Battosai42/CraftbotPlus_Upgrade/Slicer_Profiles/README.md

# Slicer Profiles

Currently there are slicer profiles for the following slicers:

- [X] [SuperSlicer](https://github.com/supermerill/SuperSlicer)

These slicer profiles work but are still under developement not opimised yet.
