Battosai42/CraftbotPlus_Upgrade/Images/mks_tft32_2.jpg

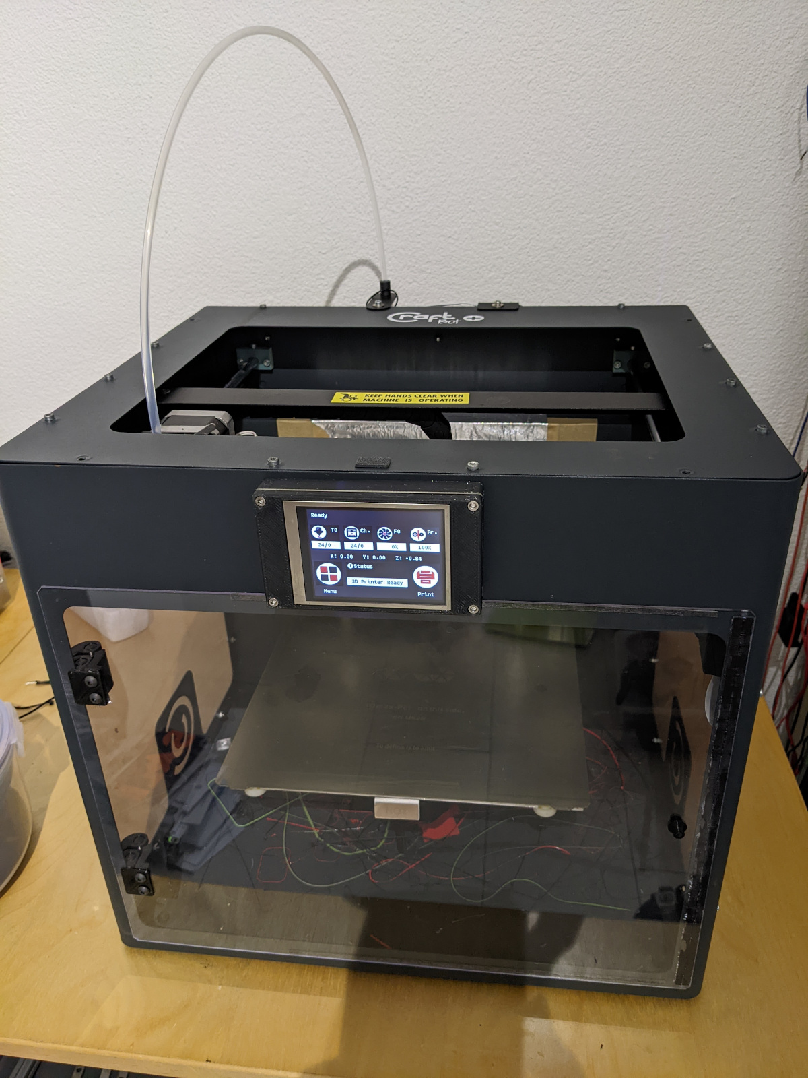
Images/mks_tft32_2.jpg
