Battosai42/CraftbotPlus_Upgrade/Upgrade_Parts/README.md

# CAD 
The following design tool are used used for all parts in this folder:

- All mechanical parts are designed in FreeCad v0.19
- All PCB's are designed in KiCad v6.0

## Printed Parts
PLA is prticularily unsuited for this application as it kreeps under stress and will become soft in the ambient temperature in the enclosure. I recommend printing the parts in ABS or another polymer with a high glass transition point as they will be operated at elevated temperatures of 50+ °C when the enclosure hood is used which makes the printer better suited to print more advanced filaments such as ABS or Nylon. 

Slicer Settings:
- 4 perimeters @0.4mm (1.6mm)
- 8 top/bottom layers @0.2mm (1.6mm)
- 40% infill

## External Mods
- [CraftBot Airflow Improvement Module (AIM)](https://www.thingiverse.com/thing:1100665)
- [Craftbot Hidden Hinge for a Front Door](https://www.thingiverse.com/thing:1472094)

## My older mods hosted on thingiverse
- [Craftbot Camera Mount](https://www.thingiverse.com/thing:2874058)
- [Craftbot Plus Belt Spacer](https://www.thingiverse.com/thing:2840977)
