Battosai42/CraftbotPlus_Upgrade/BOM.ods

BOM for Craftbot Plus Modifications
Items | Description | Link | Price
1 | Duet 3 Mini 5+ | https://e3d-online.com/products/duet-3-mini-5
1 | Duet PanelDue | https://e3d-online.com/products/duet-paneldue-display?_pos=1&_sid=3085afdef&_ss=r
 |  | Total Price | 0
