Battosai42/CraftbotPlus_Upgrade/Upgrade_Parts/Electronics/electronics_mounts.FCStd

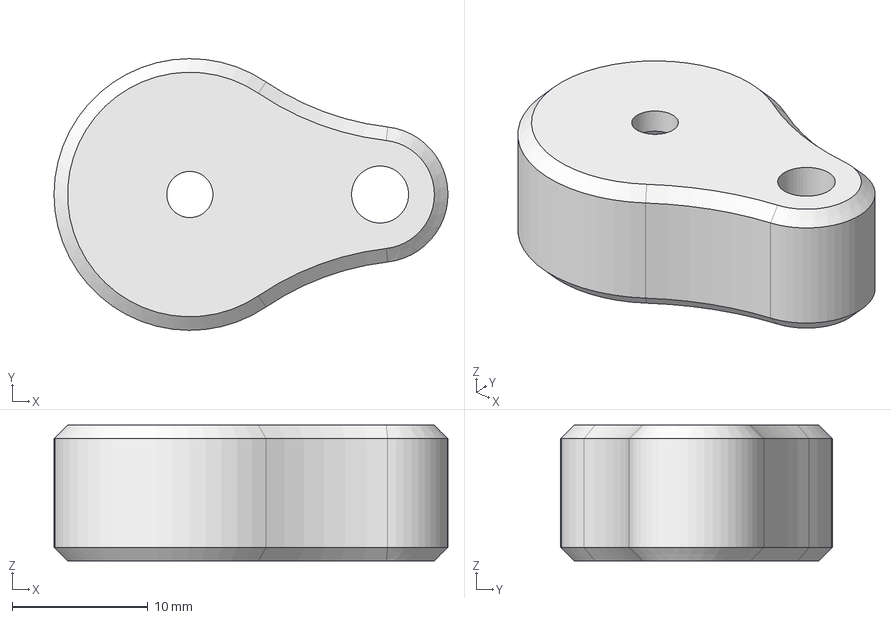
[picture p10: CAD file, 2022-03-01]
Upgrade_Parts/Electronics/electronics_mounts.FCStd
29.0 x 20.0 x 10.0 mm
