Battosai42/CraftbotPlus_Upgrade/Upgrade_Parts/Extruder/IR_probe_mount.FCStd

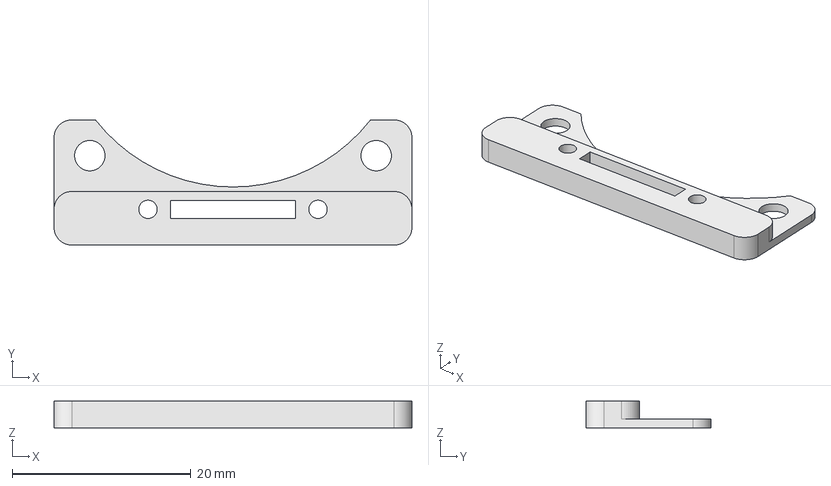
[picture p11: CAD file, 2022-03-01]
Upgrade_Parts/Extruder/IR_probe_mount.FCStd
40.0 x 14.0 x 3.00 mm
