Battosai42/CraftbotPlus_Upgrade/Upgrade_Parts/usb_lid.amf

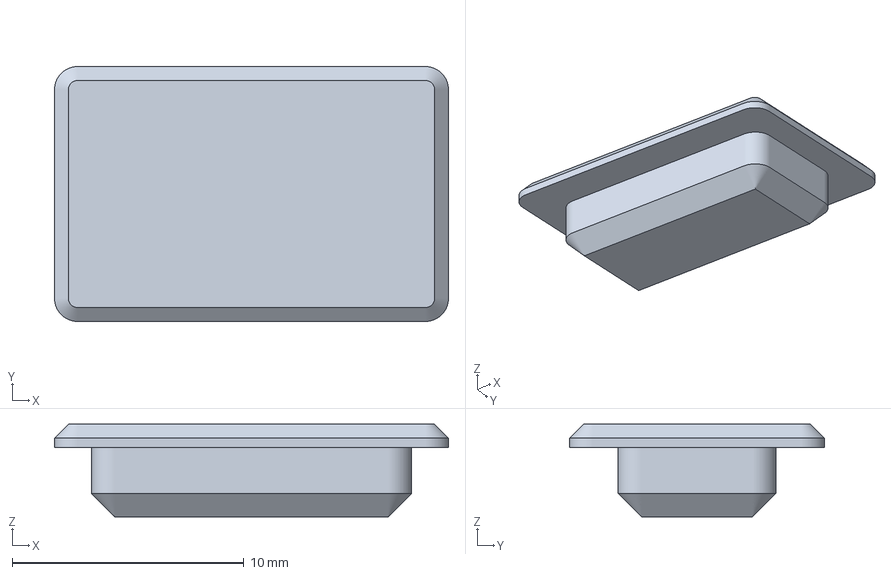
[picture p12: CAD file, 2022-04-02]
Upgrade_Parts/usb_lid.amf
17.0 x 11.0 x 4.00 mm
