Battosai42/CraftbotPlus_Upgrade/Upgrade_Parts/MKS_TFT32_mount.amf

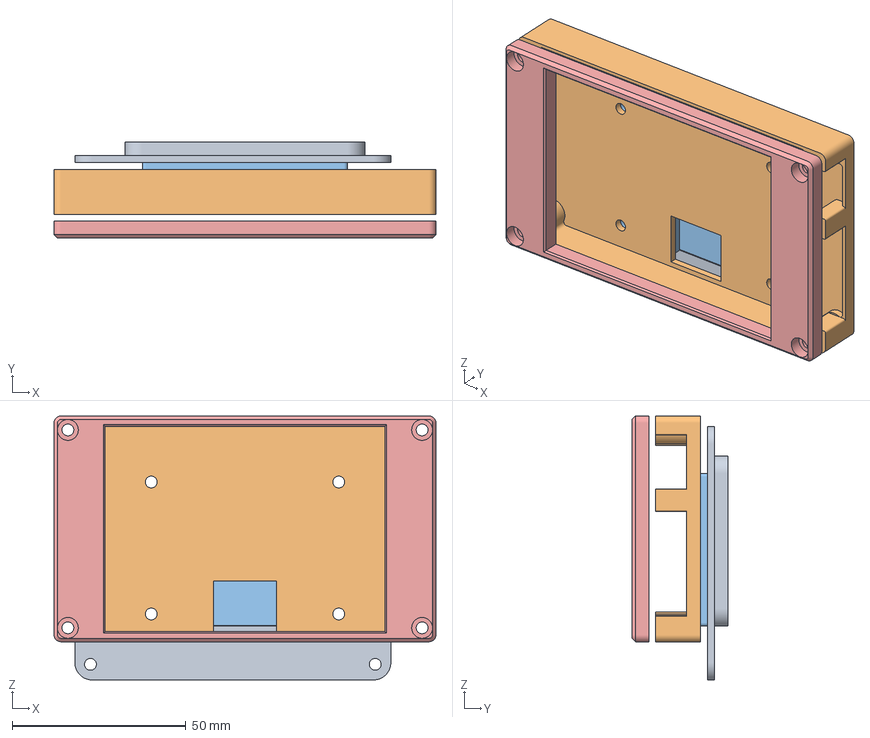
[picture p13: CAD file, 2022-04-02]
Upgrade_Parts/MKS_TFT32_mount.amf
110.0 x 27.8 x 76.0 mm
MKS_Mounting_Bracket
MKS_case_back
spacer
cable_lid
screen_bezel
