Battosai42/CraftbotPlus_Upgrade/Upgrade_Parts/BLV_Toolhead_Interface/BLV_Toolhead_Interface.pdf

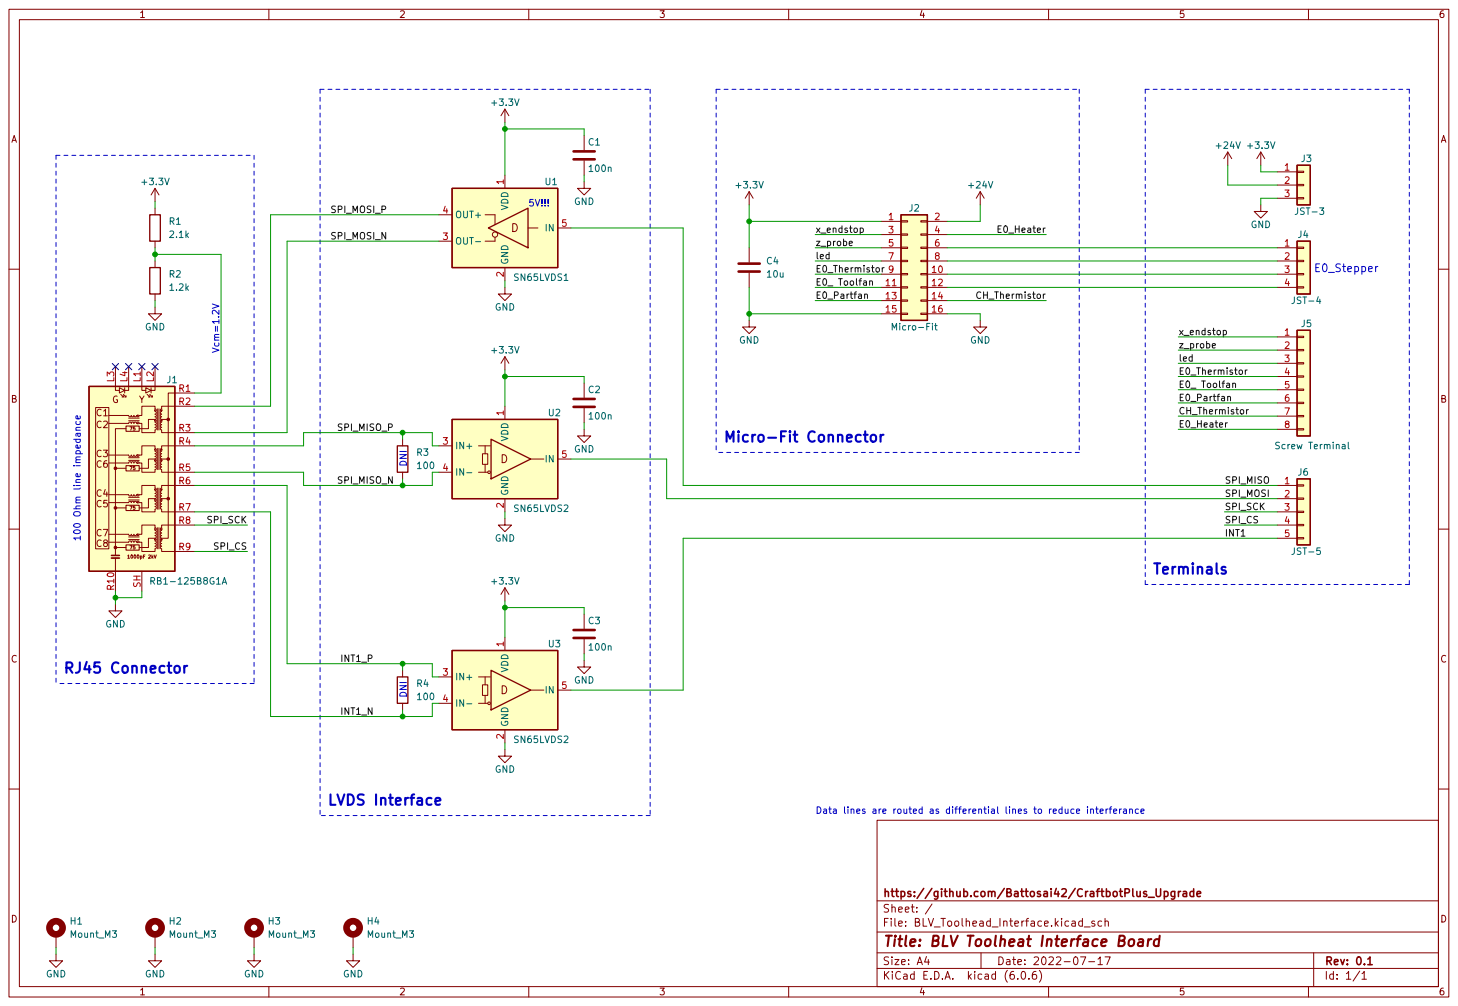
[picture p14: page 1]

SPI_MOSI_N

File: BLV_Toolhead_Interface.kicad_sch Sheet: / https://github.com/Battosai42/CraftbotPlus_Upgrade GND

Data lines are routed as differential lines to reduce interferance

Id: 1/1 Title: BLV Toolheat Interface Board
