Battosai42/CraftbotPlus_Upgrade/Upgrade_Parts/BLV_Toolhead_PCB/CB_Toolhead_PCB.pdf

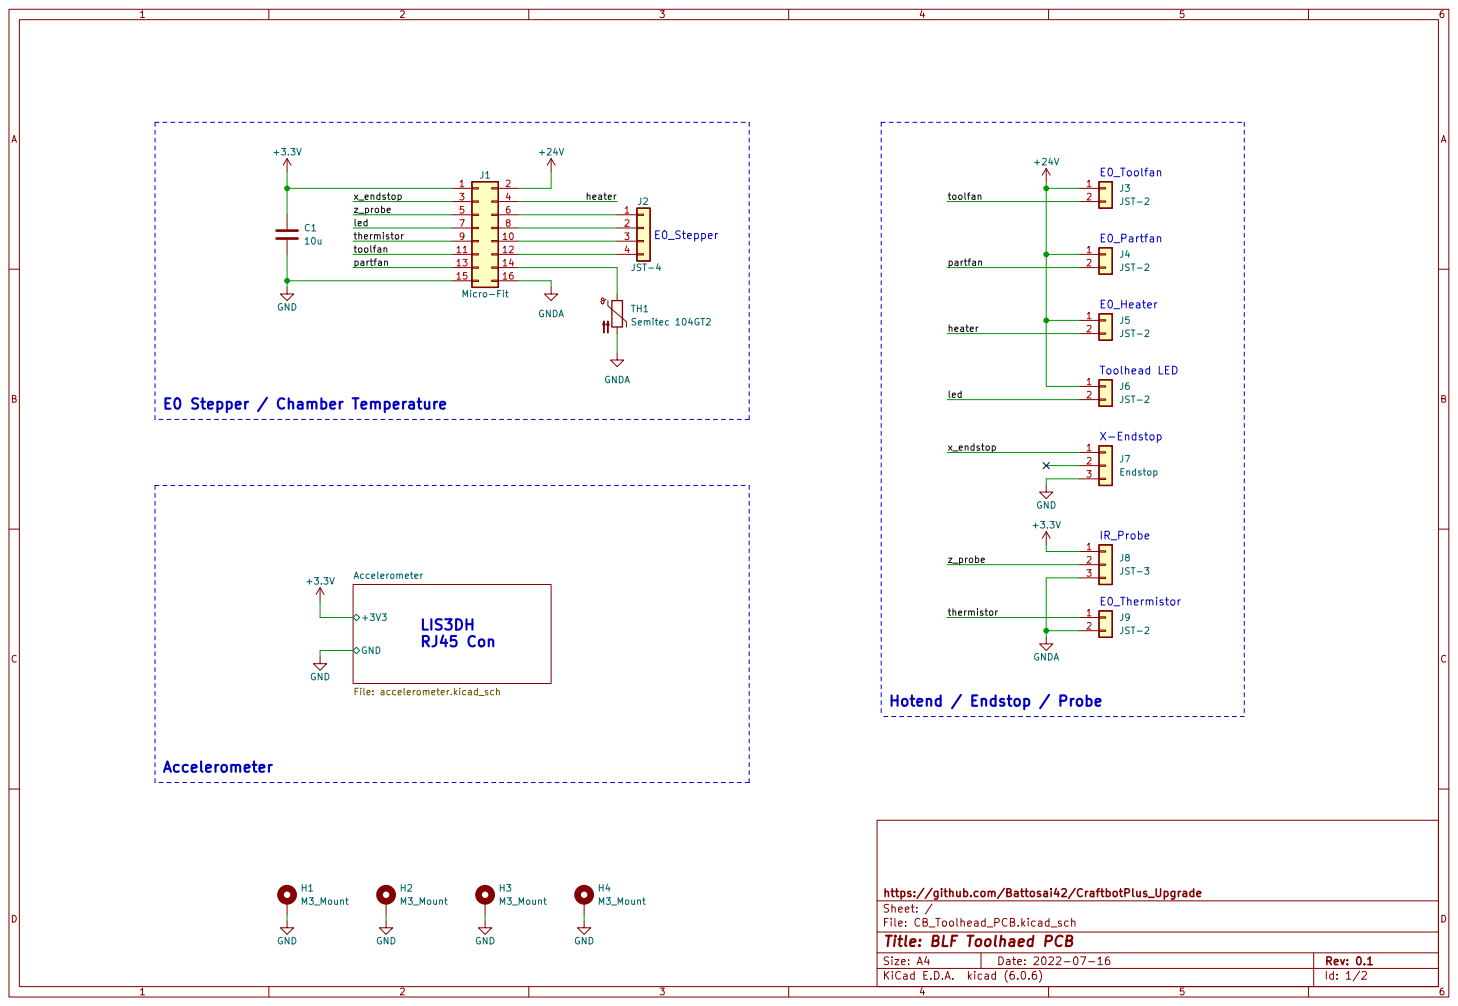
[picture p15: page 1]

File: CB_Toolhead_PCB.kicad_sch Sheet: / https://github.com/Battosai42/CraftbotPlus_Upgrade GND

Id: 1/2 Title: BLF Toolhaed PCB

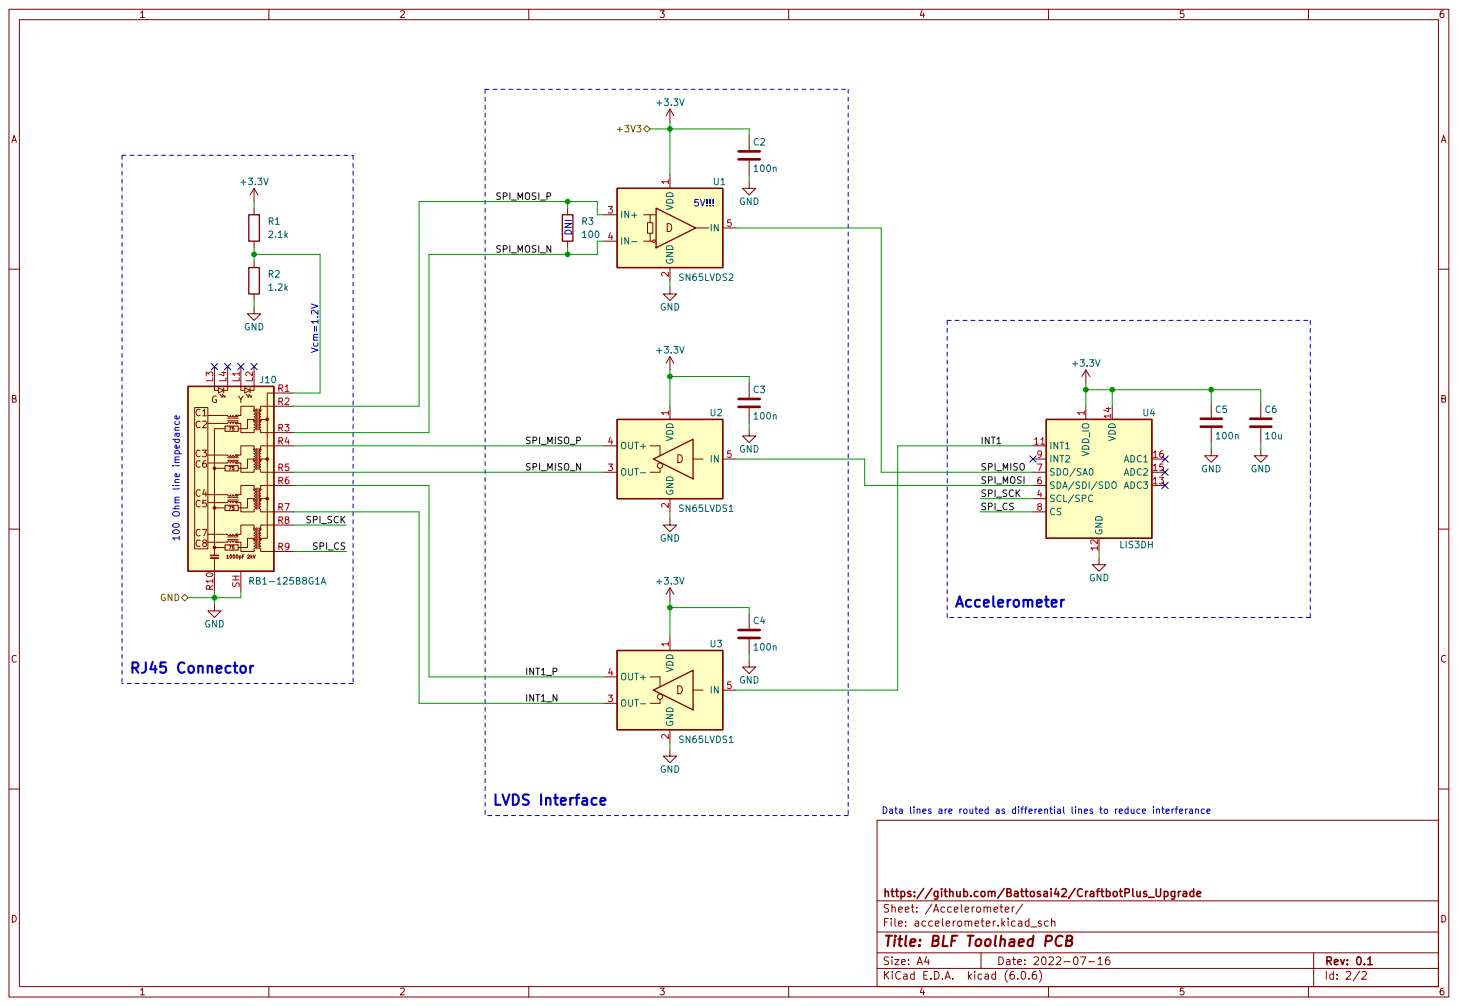
[picture p16: page 2]

LVDS Interface 100 Ohm line impedance

File: accelerometer.kicad_sch Sheet: /Accelerometer/ https://github.com/Battosai42/CraftbotPlus_Upgrade C4

Data lines are routed as differential lines to reduce interferance

Id: 2/2 Title: BLF Toolhaed PCB
