Battosai42/CraftbotPlus_Upgrade/Upgrade_Parts/BLV_Toolhead_PCB/CB_Toolhead_PCB.kicad_pcb

## KiCad design Upgrade_Parts/BLV_Toolhead_PCB/CB_Toolhead_PCB.kicad_pcb (2022-08-03)

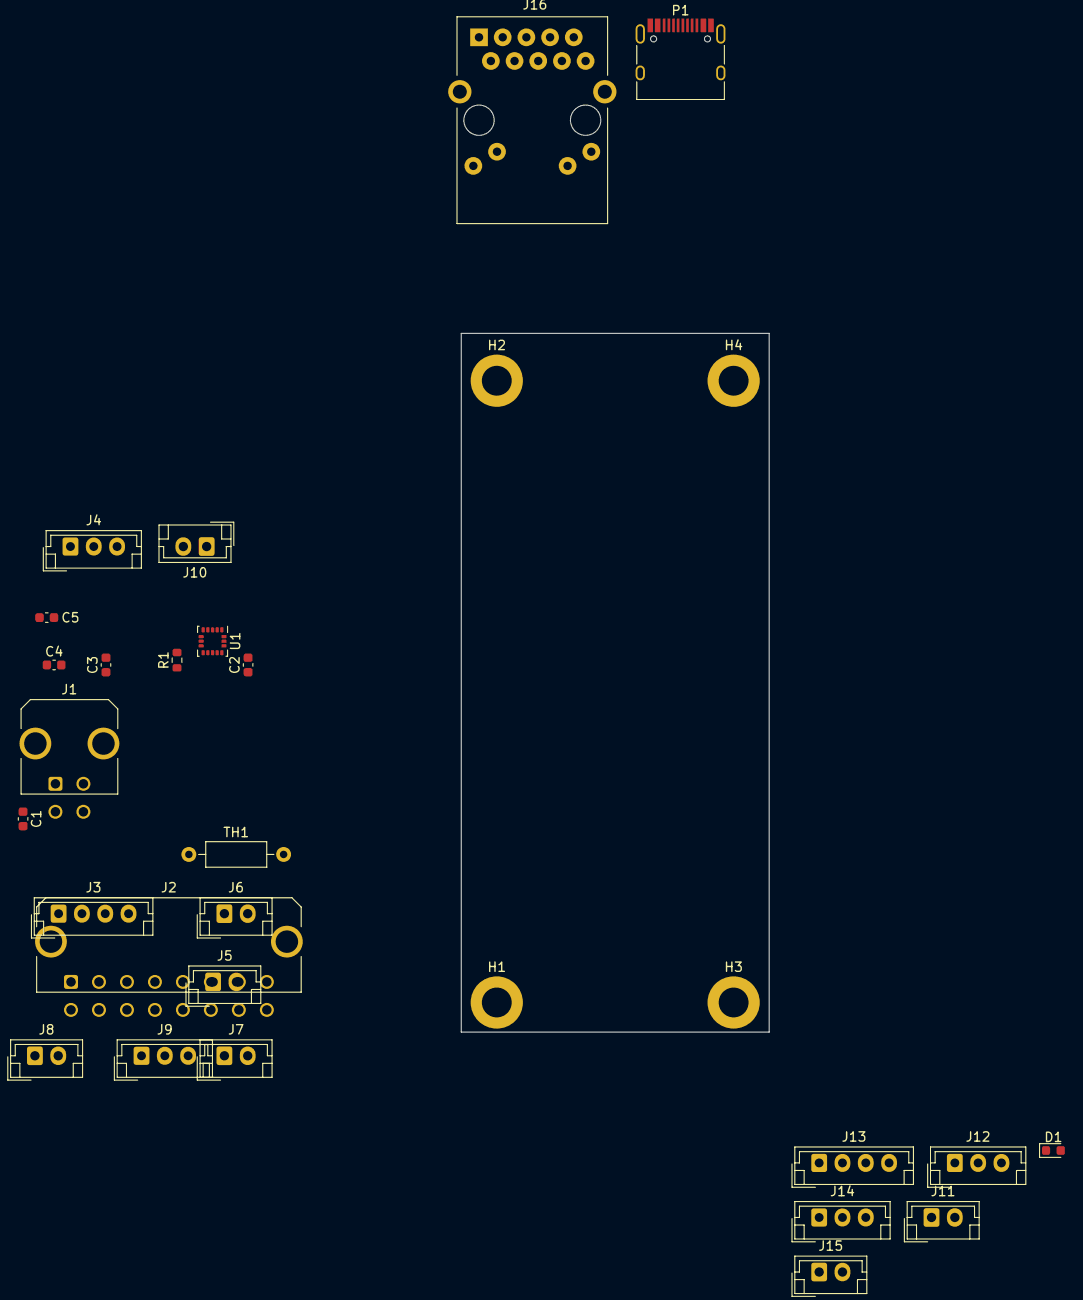
[picture p17: board CB_Toolhead_PCB.kicad_pcb from above]

Board: 2 copper layers, 33.0 x 74.9 mm, 30 parts (0 on the bottom side), 26 nets, no tracks yet.

Parts:
C1, C2, C3, C5: 10u; C_0603_1608Metric
C4: 100n; C_0603_1608Metric
D1: BAS; D_0603_1608Metric
H1, H2, H3, H4: M3_Mount; MountingHole_3.2mm_M3_DIN965_Pad
J1: Power; Molex_Micro-Fit_3.0_43045-0421_2x02-1MP_P3.00mm_Horizontal
J2: Micro-Fit; Molex_Micro-Fit_3.0_43045-1621_2x08-1MP_P3.00mm_Horizontal
J3, J13: JST-4; JST_EH_B4B-EH-A_1x04_P2.50mm_Vertical
J4, J12, J14: JST-3; JST_EH_B3B-EH-A_1x03_P2.50mm_Vertical
J5, J6, J7, J8, J10, J11, J15: JST-2; JST_EH_B2B-EH-A_1x02_P2.50mm_Vertical
J9: Endstop; JST_EH_B3B-EH-A_1x03_P2.50mm_Vertical
J16: RB1-125B8G1A; RJ45_UDE_RB1-125B8G1A
P1: USB_C_Plug_USB2.0; USB_C_Receptacle_HRO_TYPE-C-31-M-12
R1: 470R; R_0603_1608Metric
TH1: Semitec 104GT2; R_Axial_DIN0207_L6.3mm_D2.5mm_P10.16mm_Horizontal
U1: LIS3DH; LGA-16_3x3mm_P0.5mm_LayoutBorder3x5y

Connections:
+3V3: C2.1, C4.1, C5.1, J1.1, J12.1, U1.1 (VDD_IO), U1.14 (VDD)
+5V: C3.1, J1.3, J4.1, J13.1, J14.2
+24V: C1.1, J1.2, J5.1, J6.1, J7.1, J8.1, J10.1
/1A: J2.4, J3.1
/1B: J2.6, J3.2
/2A: J2.8, J3.3
/2B: J2.10, J3.4
/Accelerometer1/INT1: J16.R8 (TD4+), P1.A6 (D+), U1.11 (INT1)
/Accelerometer1/SPI_CS: J16.R6 (TD3+), P1.A7 (D-), U1.8 (CS)
/Accelerometer1/SPI_MISO: J16.R2 (TD1+), P1.A4 (VBUS), P1.A9 (VBUS), P1.B4 (VBUS), P1.B9 (VBUS), U1.7 (SDO/SA0)
/Accelerometer1/SPI_MOSI: J16.R3 (TD1-), P1.A5 (CC), U1.6 (SDA/SDI/SDO)
/Accelerometer1/SPI_SCK: J16.R4 (TD2+), P1.B5 (VCONN), U1.4 (SCL/SPC)
/heater: J2.2, J7.2
/neopixel_do: J2.5, J8.2, R1.1
/partfan: J2.11, J5.2, J10.2
/pwm_ctrl: J2.13, J14.3
/thermistor: J2.7, J11.1
/toolfan: J2.9, J6.2
/x_endstop: J2.1, J9.1
/z_probe: D1.2 (A), J2.3, J12.2, J15.2
/z_probe_th: J2.14, J13.4
GND: C1.2, C2.2, C3.2, C4.2, C5.2, H1.1, H2.1, H3.1, H4.1, J4.3, J9.3, J13.2, J14.1, J15.1, J16.R5 (TD2-), J16.R7 (TD3-), J16.R9 (TD4-), J16.R10 (GND), J16.SH, P1.A1 (GND), P1.A12 (GND), P1.B1 (GND), P1.B12 (GND), P1.S1 (SHIELD), U1.5 (GND), U1.10 (GND), U1.12 (GND)
GNDA: J1.4, J11.2, J12.3, TH1.2
unnamed: D1.1 (K), J13.3
unnamed: J2.12, TH1.1
unnamed: J4.2, R1.2
