Battosai42/CraftbotPlus_Upgrade/(commit log)

2022-03-01 added gitignore
    [BOM.ods]
2022-03-01 minor toolhead pcb update
    [CB_Toolhead_PCB.kicad_sch]
2022-03-01 remove kicad backups
2022-03-28 added model of x-carriage
2022-03-29 Update README.md
    added bed probe
2022-03-29 updated RRF config
    [bed.g, cancel.g, config-override.g, config.g, deployprobe.g, pause.g, resume.g, retractprobe.g]
2022-03-29 added hotend image
2022-04-02 updated display case files
    [MKS_TFT32_mount.amf, usb_lid.amf]
2022-07-13 added LIS3DH
    [CB_Toolhead_PCB.kicad_sch]
2022-07-16 added BLV variant
    [CB_Toolhead_PCB.kicad_pcb, CB_Toolhead_PCB.kicad_sch, accelerometer.kicad_sch]
2022-07-16 termination fix
    [CB_Toolhead_PCB.kicad_sch, accelerometer.kicad_sch]
2022-07-16 using 3.3V LVDS driver
    [CB_Toolhead_PCB.kicad_pcb, CB_Toolhead_PCB.kicad_sch, accelerometer.kicad_sch]
2022-07-16 gitignore updated
    [accelerometer.kicad_sch]
2022-07-17 added schematic pdf
2022-07-17 added interface board
    [BLV_Toolhead_Interface.kicad_pcb, BLV_Toolhead_Interface.kicad_sch]
2022-07-17 added terminals
    [BLV_Toolhead_Interface.kicad_sch, accelerometer.kicad_sch]
2022-07-17 replaced lvds drver
    [CB_Toolhead_PCB.kicad_pcb, CB_Toolhead_PCB.kicad_sch, accelerometer.kicad_sch]
2022-07-18 new page for periphery
    [CB_Toolhead_PCB.kicad_sch, periphery.kicad_sch]
2022-08-03 removed lvds drivers
    [CB_Toolhead_PCB.kicad_pcb, CB_Toolhead_PCB.kicad_sch, accelerometer.kicad_sch, periphery.kicad_sch]
